sea-deep/deeptrack/rawasset/mpu.png

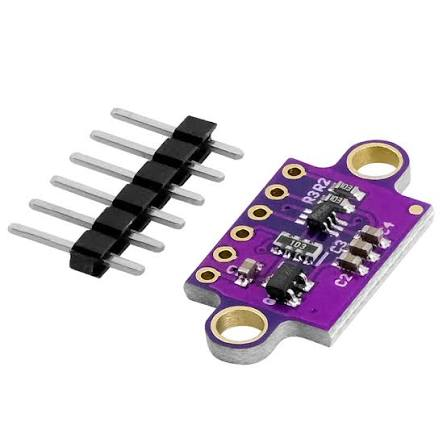
rawasset/mpu.png
