sea-deep/deeptrack/(commit log)

2026-08-23 Initial commit: Jharkhand Rover + Gateway prototype with custom chips
2026-08-23 feat: Implement fixed ultrasonic, servo VL53L0X, and single TB6612FNG
2026-08-23 fix: Resolve VL53L0X initialization handshake and add 4 TT motors to diagram
2026-08-24 docs: add hardware BOM and wiring guide, remove temp fix scripts
    - Add docs/HARDWARE_BOM.md: complete shopping list with INR estimates,
    printable checklist, corrected power architecture (separate 5V bus)
    - Add docs/WIRING_GUIDE.md: pin-by-pin wiring for Rover and Gateway,
    voltage divider circuits, motor truth table, first-power-on checklist
    - Fix: MQ-4 needs 5V + voltage divider (diagram had 3.3V, no divider)
    - Fix: separate 5V power bus (diagram routed all loads through ESP32 5V pin)
    - Fix: added decoupling capacitors to BOM (470uF on 5V, 100nF on 3V3)
    - Remove 10 temp Python fix/rewrite/update scripts from previous iterations
    - Gateway: add LED pinMode init and heartbeat toggle on seri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
2026-08-27 Update MPU image with new blue board and bump cache version
2026-08-27 Fix Railway deployment by moving railway.json to root and adding a root package.json
2026-08-27 Add BME280 sensor to hardware section
2026-08-27 Update VL53L0X image and add ToF flowchart section
2026-08-27 Style ToF flowchart section to match design
2026-08-27 Update flowchart to show Dual-ESP32 architecture as a vertical track
2026-08-27 style: fix flowchart icon clipping by setting box-sizing to content-box
2026-08-27 docs: add water sensor to landing page hardware section
